placiuga/rfid_master/projectWebsite/files/VDR3.pdf

Date, Presenter, etc.

## RFID Lab Access Control

Group 309

## Introduction: Team 309

2

Patrick Laciuga | FSU, CPE | Project Manager
Zachary Gearhart-Robboy | FSU, EE | Hardware Lead
Calvin Reinert | FSU, CPE | Software Lead
Taylor Gooden | FAMU, CPE | Database Engineer
Michael Carter | FSU, CPE | Test Engineer
Jada Truong | FSU, CPE | Communications Lead

Members:

Patrick

## Project Introduction

The Problem:
- Current student laboratories lack automated supervision, creating safety risks and making it difficult to track equipment usage.
- The FAMU-FSU College of Engineering requires a self-supervising system to act as a gatekeeper for potentially dangerous or expensive machinery.
- The system should not only track but ideally encourage responsible use of equipment

3 Patrick

## Project Introduction

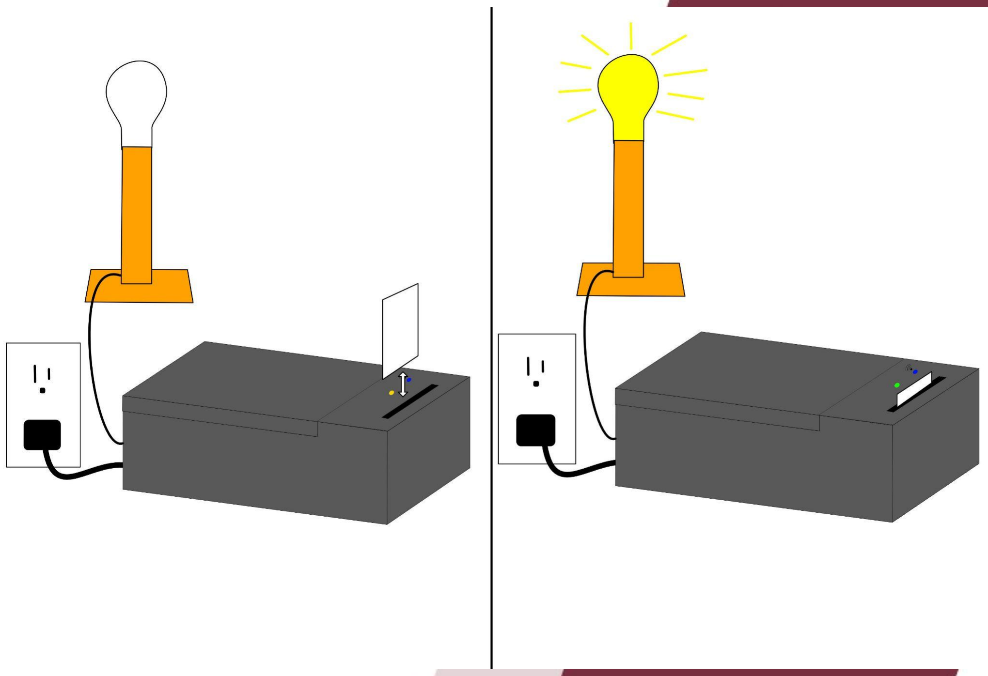
[picture p4: figure]

Solution: • An RFID-controlled power delivery system

managed by a central database.
Key Objectives: • Identify & Authenticate: Instantly verify

authorized student IDs via RFID.
- Control Power: Safely deliver 120V/20A power to connected equipment contingent on authorization.
- Resist Tampering: Ensure the system cannot be easily bypassed to plug directly into the wall.
- Maintain Flow: Provide a simple, intuitive user interface that doesn't impede authorized students from getting their work done.

4 Patrick

5

## Progress

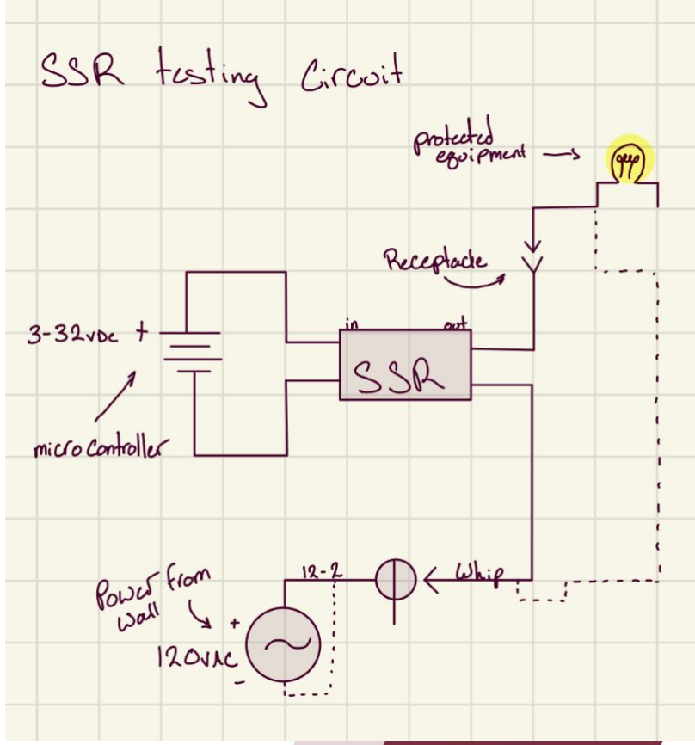
[picture p5: figure]

## SSR Progress

- SSR operates within its parameters.
- Now, we need to connect the SSR to the microcontroller and test on a circuit with a high power draw.
- Need to figure out heat dissipation.
Zachary | 6

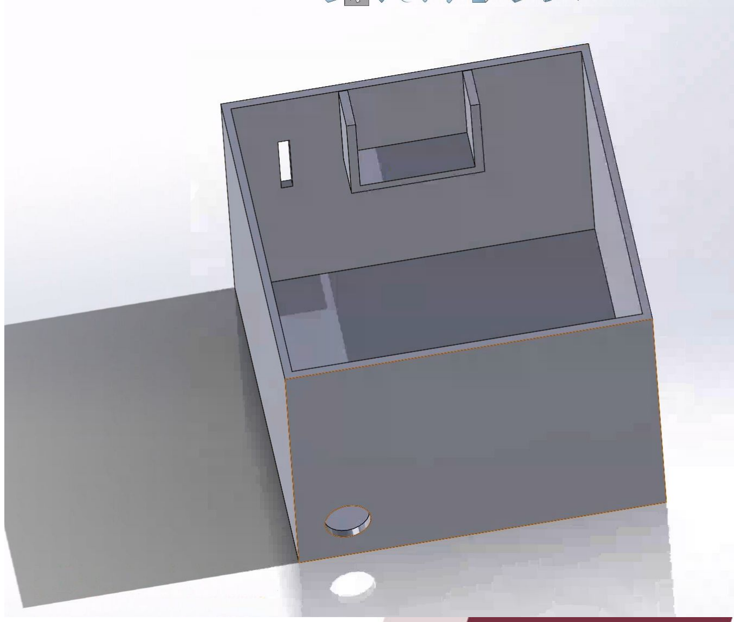
[picture p6: figure]

- Small opening for LED strip.
- Shelf to hold the RFID reader.
- Card will be inserted from the top
- 1 inch hole at the base for power cords.
- All components housed inside the box
- Currently working on printing a prototype.
Zachary | 7

## CAD design for box

8

## General Circuit Review

Wires: 120V (>20A) -> 12awg 5V (>1A) -> 28 awg
Supports: Clamp on type
Power in: 20A Pigtail plug

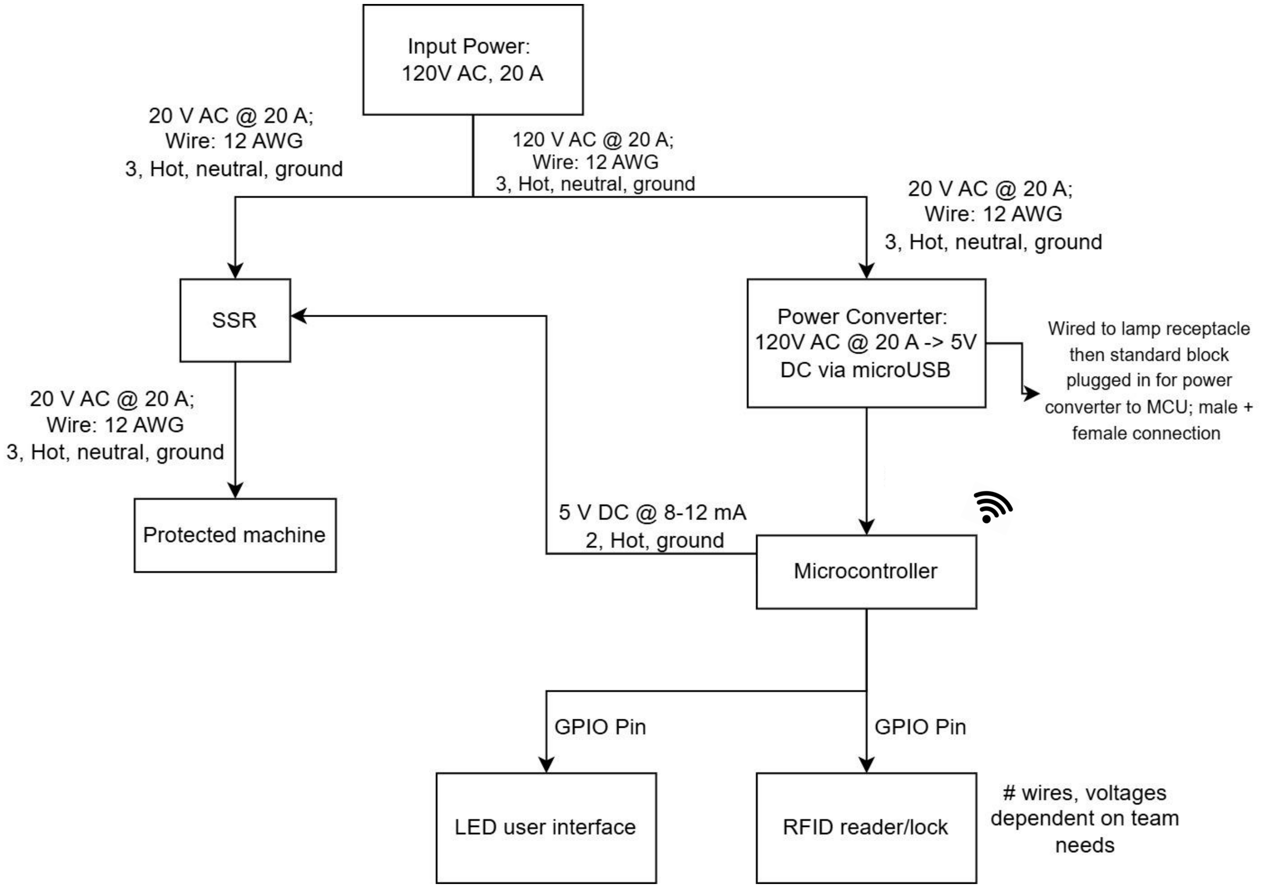
[picture p7: figure]

Zachary

## Digital Communication Flow

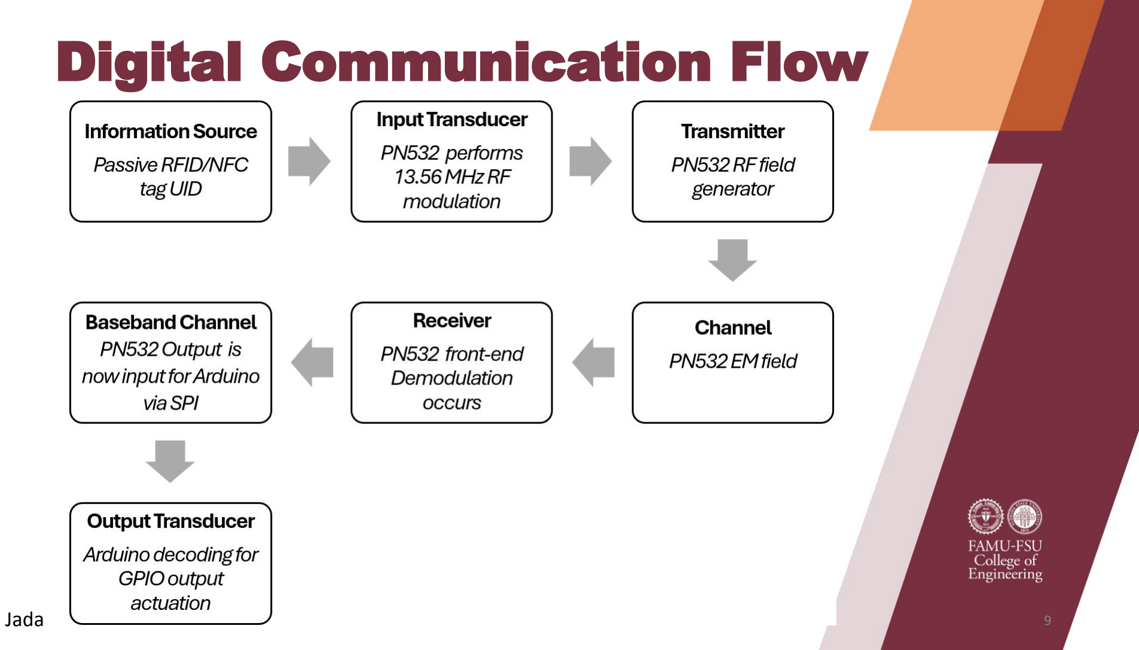
[picture p8: page 9]

Jada | 9

## Code Algorithm Progress

Done:
- Arduino WiFi connectivity
- RFID card reading capability
- LED display for statuses
Next:
- Database connectivity
- SQL command communication & logging
- Power distribution
Calvin | 10

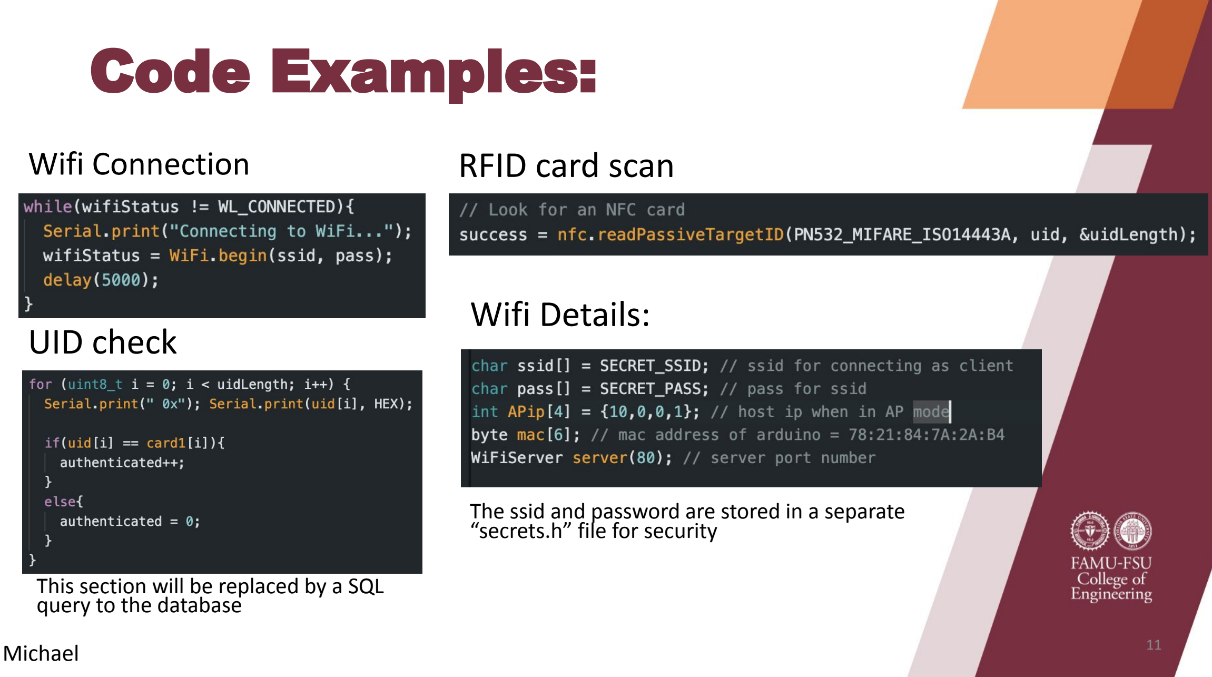
[picture p9: figure]
Code Examples:; Wifi Connection; RFID card scan; UID check; This section will be replaced by a SQL query to the database; Wifi Details:; “secrets.h” file for security; Michael

The ssid and password are stored in a separate

## Prototype Images

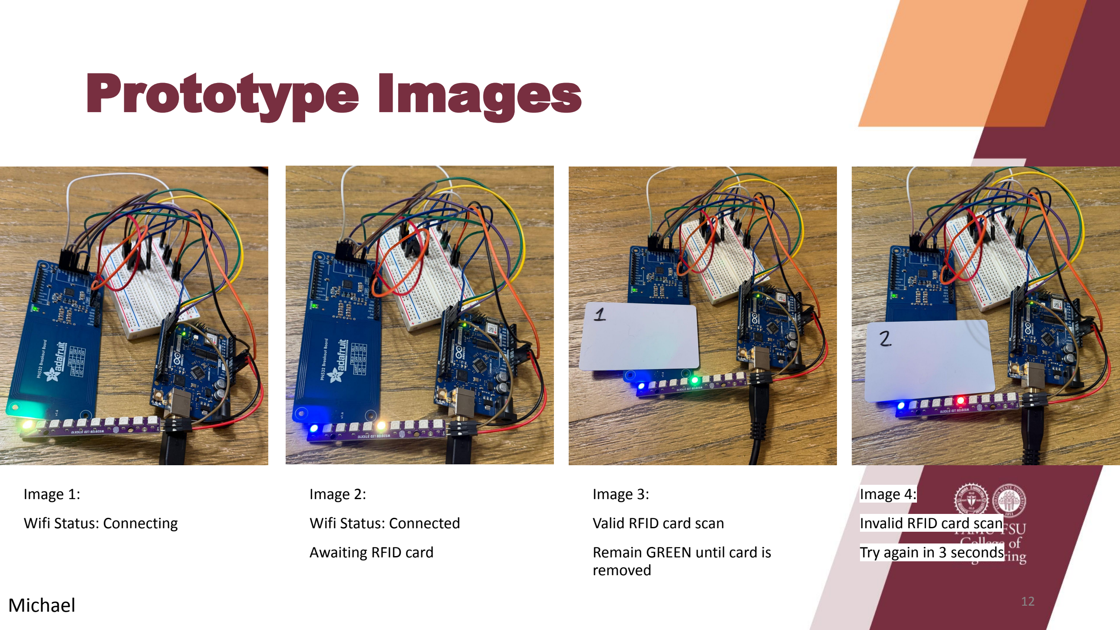
[picture p10: page 12]

Image 1:

Wifi Status: Connecting

12

Image 2:

Wifi Status: Connected

Awaiting RFID card

Image 3:

Valid RFID card scan

Remain GREEN until card is removed

Image 4:

Invalid RFID card scan

Try again in 3 seconds

Michael

## Database Schematic

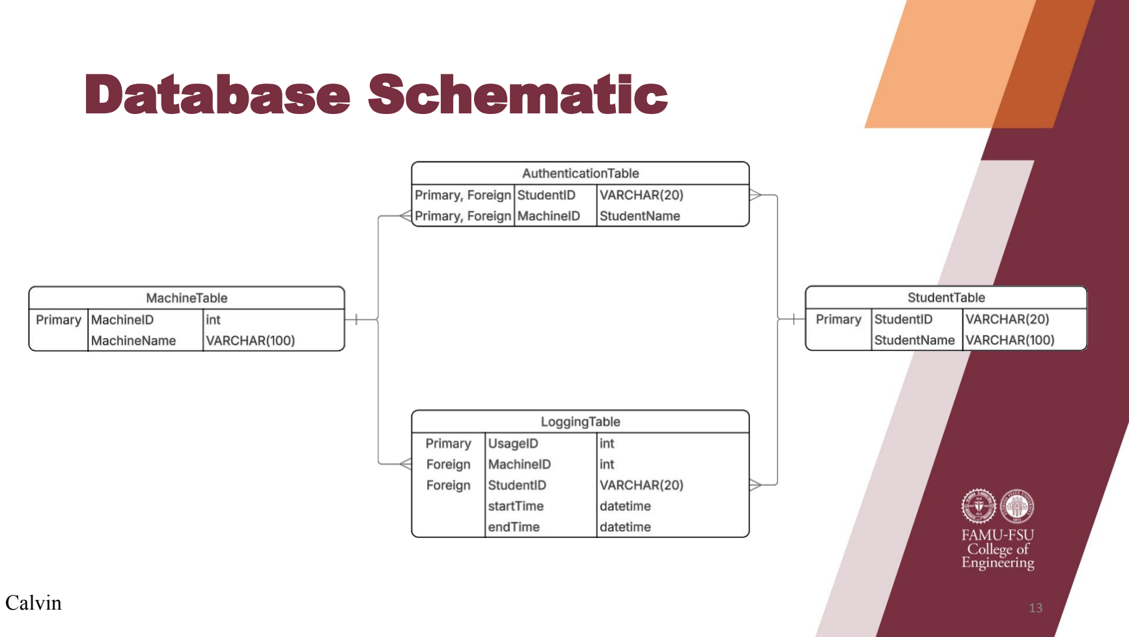
[picture p11: page 13]

Calvin | 13

## Website Progress

Current considered options

Taylor | 14

Option 1: Local Hosting

Web server running on a local machine, such as a raspberry pi.
Pi would require a static IP address for arduinos to connect.
Dependent on FSU ITS maintaining this IP Would allow for an RFID reader to be directly connected for registering new student cards. Issues with this machine would cause an outage across entire system.

Option 2: Cloud Hosting

Web server running through Microsoft Azure. Arduinos would connect to a dynamic hostname.
Does not require FSU ITS to maintain IP Would still require a dedicated machine and RFID reader to register new student cards. More reliable - built upon Azure’s infrastructure.

Web server is mostly transferable between options. Option 1 will be developed first as a prototype, and later transferred to option 2.

## Next Steps

- Print and begin testing with 3D printed parts
- Connect with FSU IT to discuss networking
- Begin testing with a local database for arduino connectivity

15 Jada
