placiuga/rfid_master/nmcli.png

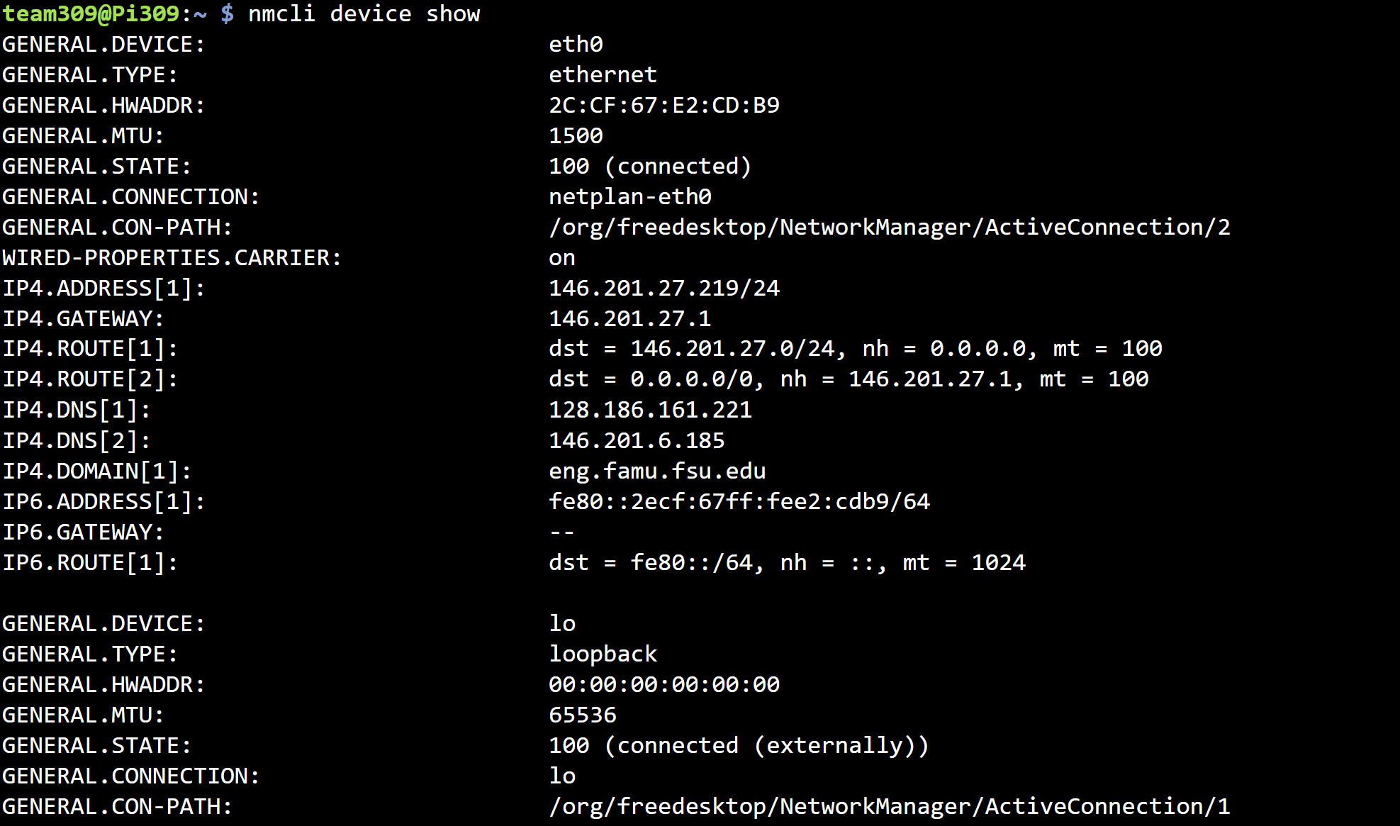
nmcli.png
