placiuga/rfid_master/boxLidAssembly/STL_Files/Full box and lid assebly - Box and Lid-1.STL

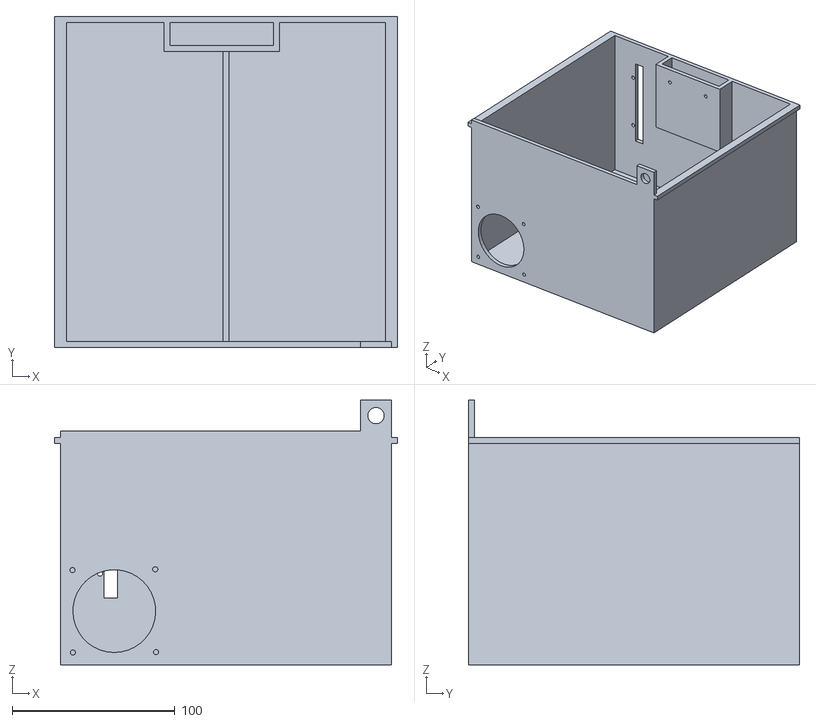
[picture p20: CAD file, 2026-04-17]
boxLidAssembly/STL_Files/Full box and lid assebly - Box and Lid-1.STL
210.8 x 203.2 x 162.6
