placiuga/rfid_master/boxLidAssembly/Solidworks_Files/Full box and lid assebly.SLDASM

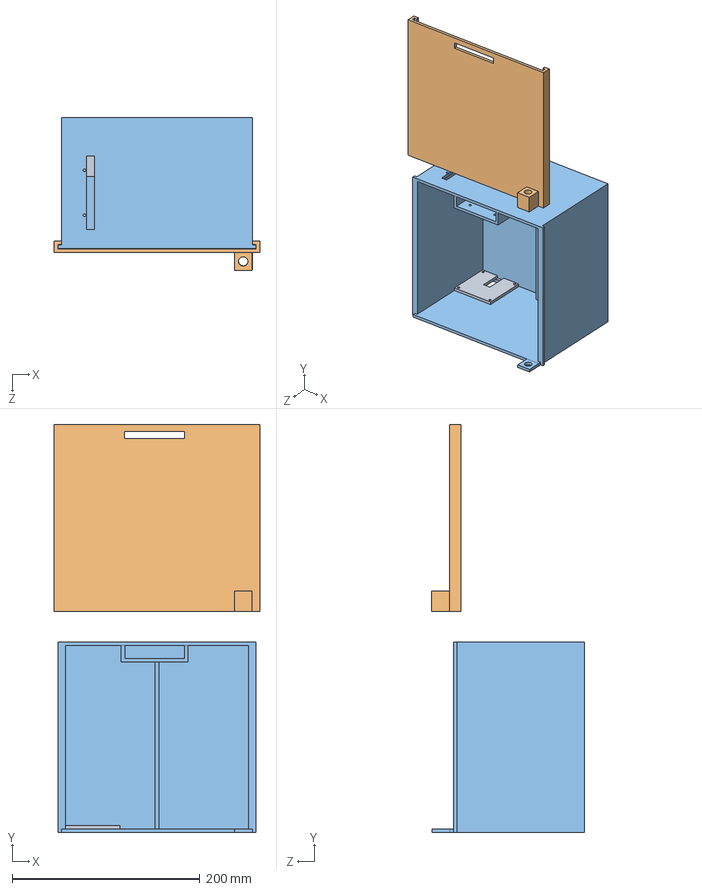
[picture p21: CAD file, 2026-04-17]
boxLidAssembly/Solidworks_Files/Full box and lid assebly.SLDASM
219.2 x 435.2 x 162.9 mm
Box and Lid
Lid
slide
