placiuga/rfid_master/boxLidAssembly/STL_Files/Full box and lid assebly - slide-2.STL

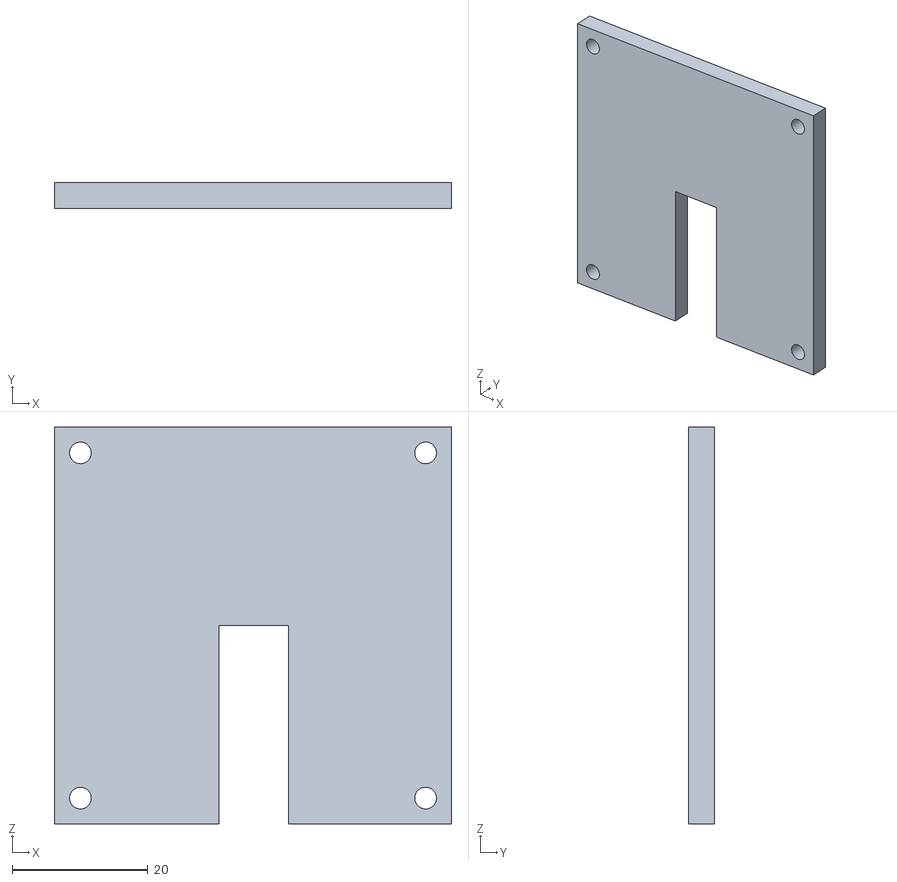
[picture p22: CAD file, 2026-04-17]
boxLidAssembly/STL_Files/Full box and lid assebly - slide-2.STL
58.4 x 3.81 x 58.4
