placiuga/rfid_master/boxLidAssembly/STL_Files/Full box and lid assebly - Lid-1.STL

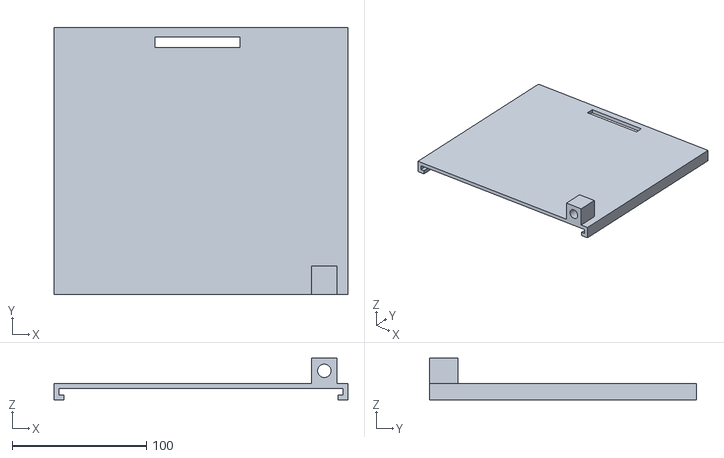
[picture p23: CAD file, 2026-04-17]
boxLidAssembly/STL_Files/Full box and lid assebly - Lid-1.STL
219.2 x 199.4 x 31.2
