placiuga/rfid_master/(list of files, cad)

Other CAD files:
boxLidAssembly/Solidworks_Files/slide.SLDPRT
boxLidAssembly/Solidworks_Files/Lid.SLDPRT
boxLidAssembly/Solidworks_Files/Box and Lid.SLDPRT
