placiuga/rfid_master/DBOperations/main.cpp

#define _CRT_SECURE_NO_WARNINGS //This is needed to use getenv without warnings when compiling in Visual Studio. It is a bad idea!

#include <iostream>
#include <string>
#include "DB.h"
#include <stdexcept>
#include <cstdlib>


using namespace std;
//-------------------------------------------------------------------------------------------/
//REQUIREMENTS:
// - ODBC Driver 17 for SQL Server must be installed on the machine running this code (can change these specifics later)
// - The connection string must be correctly configured with the appropriate server, database, user ID, and password
// - The SQL Database must allow connections from the IP address of the machine running this code (check firewall settings for Azure portal)
//-------------------------------------------------------------------------------------------/
//Useful documentation for ODBC: https://github.com/microsoft/VCSamples/blob/master/VC2015Samples/ODBC%20database%20sample%20(windows)/C%2B%2B/odbcsql.cpp

//Notes: sometimes the connection fails even if all of the above are true.
// Azure: You are probably timing out because the SQL database is not awake to begin with
//        Best fix for this is honestly just to open query editor in the portal (requires you to login + wakes up db)

string getEnvOrThrow(const char* varName) {
	const char* value = getenv(varName);
	if (!value) {
		throw runtime_error(string("Missing environment variable: ") + varName);
	}
	return string(value);
}

string uid = getEnvOrThrow("AZURE_UID"); //Get UID from environment variable
string pwd = getEnvOrThrow("AZURE_PWD"); //Get password from environment variable

//To add env variables: powershell ->
// setx AZURE_UID "username"
// setx AZURE_PWD "password"

//On linux:
// export AZURE_UID="username"
// export AZURE_PWD="password"

 
int main() {
	//IMPORTANT: you will need to add your own UID and PASSWORD since this is a public repo

	string connectionString = //ODBC connection string direct from Azure portal 
		"Driver={ODBC Driver 17 for SQL Server};"
		"Server=tcp:rfid309.database.windows.net,1433;"
		"Database={RFID DB};"
		"Uid=" + uid + ";"
		"Pwd=" + pwd + ";"
		"Encrypt=yes;"
		"TrustServerCertificate=no;"
		"Connection Timeout=60;";

	
	DbConnection db;

	std::cout << "Attempting to log in as user: " << uid << std::endl;
	
	if(!dbConnect(db, connectionString)) {
		cerr << "Failed to connect to database. Exiting." << endl;
		return 1; //Exit with error code if connection fails
	}

	//Documentation: https://learn.microsoft.com/en-us/sql/odbc/reference/develop-app/executing-a-statement?view=sql-server-ver17

	SQLHSTMT stmtHandle; //Statement handle for executing SQL commands
	SQLCHAR* Table;

	if (SQLAllocHandle(SQL_HANDLE_STMT, db.connHandle, &stmtHandle) != SQL_SUCCESS)
	{
		print_error("SQLAllocHandle for statement failed", db.connHandle, SQL_HANDLE_DBC);
		return 1;
	}
	//Allocate a statement handle using the connection handle

	SQLRETURN retTables = SQLExecDirectA(stmtHandle, (SQLCHAR*)"SELECT TABLE_NAME FROM INFORMATION_SCHEMA.TABLES WHERE TABLE_TYPE = 'BASE TABLE'", SQL_NTS); //Execute a query to get table names
	SQLCHAR col1[256] = { 0 }; //Buffer to hold the table name 
	SQLLEN col1Len = 0; //Variable to hold the length of the retrieved data

	SQLBindCol(stmtHandle, 1, SQL_C_CHAR, col1, sizeof(col1), &col1Len); //Bind the first column of the result to col1 buffer

	while ((retTables = SQLFetch(stmtHandle)) == SQL_SUCCESS || retTables == SQL_SUCCESS_WITH_INFO) {
		//Fetch each row of the result
		cout << col1 << endl;
	}

	std::cout << "Select a table to view: ";
	string selectedTable;
	cin >> selectedTable;
	if(!selectedTable.empty()) {
		string query = "SELECT * FROM " + selectedTable; //Construct a query to select all data from the chosen table
		SQLRETURN retQuery = SQLExecDirectA(stmtHandle, (SQLCHAR*)query.c_str(), SQL_NTS); //Execute the query
		if (retQuery != SQL_SUCCESS && retQuery != SQL_SUCCESS_WITH_INFO) {
			print_error("Failed to execute query: " + query, db.connHandle, SQL_HANDLE_DBC);
			return 1;
		}
		std::cout << "Executed query: " << query << std::endl;

	}

	SQLCloseCursor(stmtHandle); //Close the cursor to reset the statement handle for the next query


	SQLSMALLINT numCols;
	SQLNumResultCols(stmtHandle, &numCols); //Get the number of columns in the result set
	for(int i = 1; i <= numCols; i++) {
		SQLCHAR colName[256] = { 0 };
		SQLDescribeColA(stmtHandle, i, colName, sizeof(colName), NULL, NULL, NULL, NULL, NULL); //Get the name of each column
		std::cout << "Column " << i << ": " << colName << std::endl;
	}



	dbDisconnect(db); //Disconnect from the database when done
	return 0; //Exit with success code
}
