placiuga/rfid_master/ARDUINO/enterprise/enterprise.ino

/*
  This example connects to a WPA2 Enterprise WiFi network.
  Then it prints the MAC address of the WiFi module,
  the IP address obtained, and other network details.

  Based on ConnectWithWPA.ino by dlf (Metodo2 srl) and Tom Igoe
*/

//Example file has been separated into headers and source files for better organization and readability


#include "enterprise.h"

#include "arduino_secrets.h"

WiFiClient client;
char server[] = SECRET_IP; //This is my laptop's ipv4 address, will replace with pi eventually

///////please enter your sensitive data in the Secret tab/arduino_secrets.h
char ssid[] = SECRET_SSID;  // your WPA2 enterprise network SSID (name)
char user[] = SECRET_USER;  // your WPA2 enterprise username
char pass[] = SECRET_PASS;  // your WPA2 enterprise password
int status = WL_IDLE_STATUS;     // the WiFi radio's status
String machineID;
uint8_t uid[] = {0, 0, 0, 0, 0, 0, 0};
uint8_t uidLength;
bool cardPresent = false;
bool authorized = false;
String lastUID = "";  

void setup() {
  pinMode(SSRPIN, OUTPUT);
  digitalWrite(SSRPIN, LOW); 
  LEDsetup();
  nfcStartup();
  serialConnect();
	enterpriseConnect(ssid, user, pass);
	serverConnect(server);
  Serial.println("getMACString: " + getMACString());
  if(verifyEquipment(getMACString(), server))
  {
    String id = getMachineID(getMACString(), server);
    if(id == "error") {
      Serial.println("Error retrieving machineID. Check server connection and database.");
	}
    else {
        machineID = id;
        pixels.show();
    }
  }
  else Serial.println("Verification failed");
}

void loop() {
  String currentUID = "";
  while(nfc.readPassiveTargetID(PN532_MIFARE_ISO14443A, uid, &uidLength)) {
    currentUID = uidToString(uid, uidLength);
    if(!cardPresent) {
      cardPresent = true;
      lastUID = currentUID;
      authorized = sendData(server, machineID, currentUID, "start");
    }
    break;
  }

  if (cardPresent && (currentUID != lastUID)) {

    cardPresent = false;
    if (authorized) {
      sendData(server, machineID, lastUID, "end");
    }
    pixels.setPixelColor(LEDAuth, 255, 255, 0); 
    pixels.show();
  }
}
