placiuga/rfid_master/AdminPanel/pythonTool/adminFunctions.py

import board
import busio
import digitalio
from adafruit_pn532.spi import PN532_SPI
from rich import print
from rich.table import Table
from rich.console import Console
from rich.panel import Panel
from rich.align import Align
import mariadb
import sys

def authorizeNewUser(conn, pn532):
    print("Configuring PN532 RFID reader...")
    print("Waiting for tag...")
    while True:
        uid = pn532.read_passive_target(timeout=1.0)
        if uid is not None:
            print("Tag detected! UID:", [hex(i) for i in uid])
            break
    uidStr = ''.join(f'{i:02X}' for i in uid) ##Convert UID to hex string (join i in uid with uppercase hex, pad to 2 chars to add leading zero)
    try:
        cur = conn.cursor()
        query = f"SELECT * FROM UserTable WHERE rfid_uid = '{uidStr}'"
        cur.execute(query)
        user = cur.fetchone()
        if user is None:
            print("Error: No user found with this RFID UID. Please create a user before authorizing.")
            return
        print(f"User found: {user[1]} (UserID: {user[0]}, FSUID: {user[2]}, Status: {user[3]})")
        print("Showing available machines:")
        queryEquip = "SELECT * FROM MachineTable"
        cur.execute(queryEquip)
        equipment = cur.fetchall()
        table = Table(title = "MachineTable")

        cols = [desc[0] for desc in cur.description]
        for col in cols:
            table.add_column(col)
        for row in equipment:
            table.add_row(*[str(value) for value in row])

        console = Console()
        console.print(table)

        equipSelection = input("Enter the MachineID of the machine to authorize access to:")
        while not any(str(row[0]) == equipSelection for row in equipment):
            print("Invalid MachineID. Please enter a valid MachineID from the MachineTable.")
            equipSelection = input("Enter the MachineID of the machine to authorize access to (or type 'cancel' to leave):")
            if equipSelection.lower() == 'cancel':
                print("Authorization cancelled. Returning to main menu.")
                return

        machineName = next(row[1] for row in equipment if str(row[0]) == equipSelection)
        print(f"Selected machine: {machineName} (MachineID: {equipSelection})")
        notes = input("Enter any notes for this authorization (up to 255 chars) or leave blank:")
        if len(notes) > 255:
            print("Notes too long, truncating to 255 characters.")
            notes = notes[:255]

        grantedBy = input("Enter your name to be recorded as the grantor of this authorization:")

        auth = input(f"Confirm that you want to authorize user {user[1]} (UserID: {user[0]}) for machine {machineName} with MachineID {equipSelection}. Type 'confirm' to proceed or 'cancel' to abort.")
        if auth.strip().lower() == 'confirm':
            cur.execute(
                 "INSERT INTO MachineAuthorizations (MachineID, notes, granted_by, UserID) VALUES (?, ?, ?, ?)",
                 (equipSelection, notes, grantedBy, user[0])
            )
            conn.commit()
            print("Authorization successful! Record added to MachineAuthorizations.")
        else:
            print("Authorization cancelled. Returning to main menu.")
            return

    except mariadb.Error as e:
        print(f"Error executing query: {e}")


def setup_pn532():
    spi = busio.SPI(board.SCK, board.MOSI, board.MISO)
    cs = digitalio.DigitalInOut(board.D25) ##Pin 22 on the Pi
    pn532 = PN532_SPI(spi, cs, debug=False)
    ic, ver, rev, support = pn532.firmware_version
    print("Found PN532: ver={ver}.{rev}, support={support}".format(ver=ver, rev=rev, support=support))
    pn532.SAM_configuration()
    return pn532


def create_user(conn, pn532):
    print("Configuring PN532 RFID reader...")
    print("Waiting for tag...")
    while True:
        uid = pn532.read_passive_target(timeout=1.0)
        if uid is not None:
            print("Tag detected! UID:", [hex(i) for i in uid])
            break
    uidStr = ''.join(f'{i:02X}' for i in uid) ##Convert UID to hex string (join i in uid with uppercase hex, pad to 2 chars to add leading zero)
    name = input("Enter student name: ")
    userID = input("TEMP: Enter PK UserID: ")
    FSUID = input("Enter FSUID: ")
    status = input("Enter status (active/inactive): ")
    print(f"Creating user with name: {name}, userID: {userID}, FSUID: {FSUID}, status: {status}")
    query = f"INSERT INTO UserTable (UserID, Name, FSUID, Status, rfid_uid) VALUES ('{userID}', '{name}', '{FSUID}', '{status}', '{uidStr}')"
    print("Executing query:", query)

    try:
        cur = conn.cursor()
        existCheck = f"SELECT * FROM UserTable WHERE rfid_uid = '{uidStr}'"
        cur.execute(existCheck)
        if cur.fetchone() is not None:
            print("Error: A user with this RFID UID already exists in the database. Aborting user creation.")
            return
        cur.execute(query)
        conn.commit()
        print(f"\nQuery executed successfully. {cur.rowcount} row(s) affected.")
        print("Success! User created.")

    except mariadb.Error as e:
        print(f"Error executing query: {e}")


def delete_user(conn, pn532):
    print("Configuring PN532 RFID reader...")
    print("Waiting for tag...")
    while True:
        uid = pn532.read_passive_target(timeout=1.0)
        if uid is not None:
            print("Tag detected! UID:", [hex(i) for i in uid])
            break
    uidStr = ''.join(f'{i:02X}' for i in uid) ##Convert UID to hex string (joins i in uid with uppercase hex, pad to 2 chars to add leading zero)
    print(f"Searching database for user with RFID UID: {uidStr}")
    queryUser = f"SELECT * FROM UserTable WHERE rfid_uid = '{uidStr}'"
    try:
        cur = conn.cursor()
        cur.execute(queryUser)
        if cur.description:
            cols = [desc[0] for desc in cur.description]
            rows = cur.fetchall()

            table = Table(title = "Query Results")
            for col in cols:
                table.add_column(col)
            for row in rows:
                table.add_row(*[str(value) for value in row])
                userIDint = rows[0][0]
            console = Console()
            console.print(table)
            if not rows:
                print("(no rows returned from UserTable)")
    except mariadb.Error as e:
        print(f"Error executing query: {e}")

    queryAuth = f"SELECT * FROM MachineAuthorizations WHERE UserID = '{userIDint}'"
    try:
        cur = conn.cursor()
        cur.execute(queryAuth)
        if cur.description:
            cols = [desc[0] for desc in cur.description]
            rows = cur.fetchall()

            table = Table(title = "Query Results")
            for col in cols:
                table.add_column(col)
            for row in rows:
                table.add_row(*[str(value) for value in row])

            console = Console()
            console.print(table)
            if not rows:
                print("(no rows returned from MachineAuthorizations)")
    except mariadb.Error as e:
        print(f"Error executing query: {e}")
    print("WARNING: This will permanently delete the user and all their authorization records from the database. Type 'confirm' to proceed or 'cancel' to abort.")
    confirm = input("Confirm> ").strip()
    if confirm.lower() == 'confirm':
        deleteAuthQuery = f"DELETE FROM MachineAuthorizations WHERE UserID = '{userIDint}'"
        try:
            cur = conn.cursor()
            cur.execute(deleteAuthQuery)
            conn.commit()
            print(f"\nUser and associated authorization records deleted successfully.")
        except mariadb.Error as e:
            print(f"Error executing delete queries: {e}")

def editTables(conn):
    console = Console()
    cur = conn.cursor()

    table = Table(title="Database Tables")
    table.add_column('#', justify="right", style="dim")
    table.add_column("Table Name", style="cyan", no_wrap=True)

    numTables = 0
    tables = []
    cur.execute("SHOW TABLES;")
    for i, (tableName,) in enumerate(cur, start=1):
        table.add_row(str(i), tableName)
        numTables = numTables + 1
        tables.append(tableName)

    console.print(table)

    sel = input("Choose a table to edit or type 'cancel' to return to main menu:")
    if(sel.lower() == 'cancel'):
        print("Returning to main menu.")
        return
    try:
        selNum = int(sel)
        if selNum < 1 or selNum > numTables:
            print("Invalid selection. Returning to main menu.")
            return
        cur.execute(f"SELECT * FROM {tables[selNum-1]};")
        cols = [desc[0] for desc in cur.description]
        rows = cur.fetchall()
        table = Table(title = f"Contents of {tables[selNum-1]}")
        for col in cols:
            table.add_column(col)
        for row in rows:
            table.add_row(*[str(value) for value in row])
        console.print(table)

    except ValueError:
        print("Invalid input. Returning to main menu.")
        return


def executeSQL(conn):
    print("WARNING: This option allows you to execute raw SQL queries on the database. Use with caution!")
    print("Type 'cancel' to return to main menu.")
    query = input("SQL> ").strip()
    if query.lower() == 'cancel' or not query:
        print("Returning to main menu.")
        return

    try:
        cur = conn.cursor()
        cur.execute(query)
        if cur.description:
            cols = [desc[0] for desc in cur.description]
            rows = cur.fetchall()

            print(f"Query executed successfully. {len(rows)} rows returned.")
            table = Table(title = "Query Results")
            for col in cols:
                table.add_column(col)
            for row in rows:
                table.add_row(*[str(value) for value in row])

            console = Console()
            console.print(table)
            if not rows:
                print("(no rows returned)")

        else:
            conn.commit()
            print(f"\nQuery executed successfully. {cur.rowcount} row(s) affected.")


    except mariadb.Error as e:
        print(f"Error executing query: {e}")
