placiuga/rfid_master/(commit log)

2026-02-27 added functionality to make queries using statement handle - currently just displays names of all tables
2026-02-27 uid and pwd now come from environment variables to prevent accidental leaks from testing with plaintext ... azure db owner password has also been changed
    [main.cpp]
2026-03-05 UNTESTED ON ARDUINO - enterprise connect + server connect functions have been split into header/source files for readability
2026-03-08 Added sendData function
    new function sends arduino data to php script which checks against the db, logs, and sends response back to arduino.
    to add: senddata functionality to change a boolean(maybe) variable that will toggle a pin on the arduino for power, also need to work on LED support from senddata
2026-03-09 moved files back, no clue what was wrong
    [enterprise.cpp, enterprise.h, enterprise.ino]
2026-03-09 added back missing sendData header
    [enterprise.h]
2026-03-09 reversed MAC address order (first 8 bytes should be identical on same board model)
    [enterprise.cpp]
2026-03-09 Moved enterprise files into enterprise folder since wouldnt work in arduino IDE ??
2026-03-25 RFID SCAN CODE
    This code needs reworking into different functions.
    Also needs to add the database connectivity. Right now it simply checks the scanned uid against a hard coded uid to determine authentication.
    [database_test_old.ino]
2026-03-26 Cleaned up code + made ready for DB
    Cleaned up code. Made it so that the scanned uid will only be checked for authorization once. The uid will be checked again once a new card is inserted.
2026-03-29 added LED compatibility to main enterprise & authorization checking to sendData
2026-03-29 adds rfid reading capability + allows for arduino to easily scan authorization
2026-03-30 all prev. tests passed. added style to menu printing
2026-04-01 added functionality to drop users from auth/user tables. NOTE: foreign keys could provide an avenue cascading deletions, I didn't mess with it. Will raise an issue/to-do
    [pythonTool.py]
2026-04-06 added LED libraries
2026-04-06 verifyEquipment tests passed on Pi309. Presentation Arduino now exists as MachineID=2, MachineName = NULL, ArduinoMAC = B42A7A842178
2026-04-06 errors with markup fixed
    [pythonTool.py]
2026-04-15 Update adminFunctions.py, just fixed the order of some queries to match database
    [adminFunctions.py]
2026-04-15 added the dump of the database in case of issues
2026-04-15 Changed deviceID stored value to 1
2026-04-15 fixed ssr and verify
    [enterprise.cpp, enterprise.ino]
2026-04-17 Fixed LED positioning and standby logic
    [enterprise.cpp, enterprise.h, enterprise.ino]
